mariusmotea/Home-Power-Monitor/Schematic_Power-Meter.png

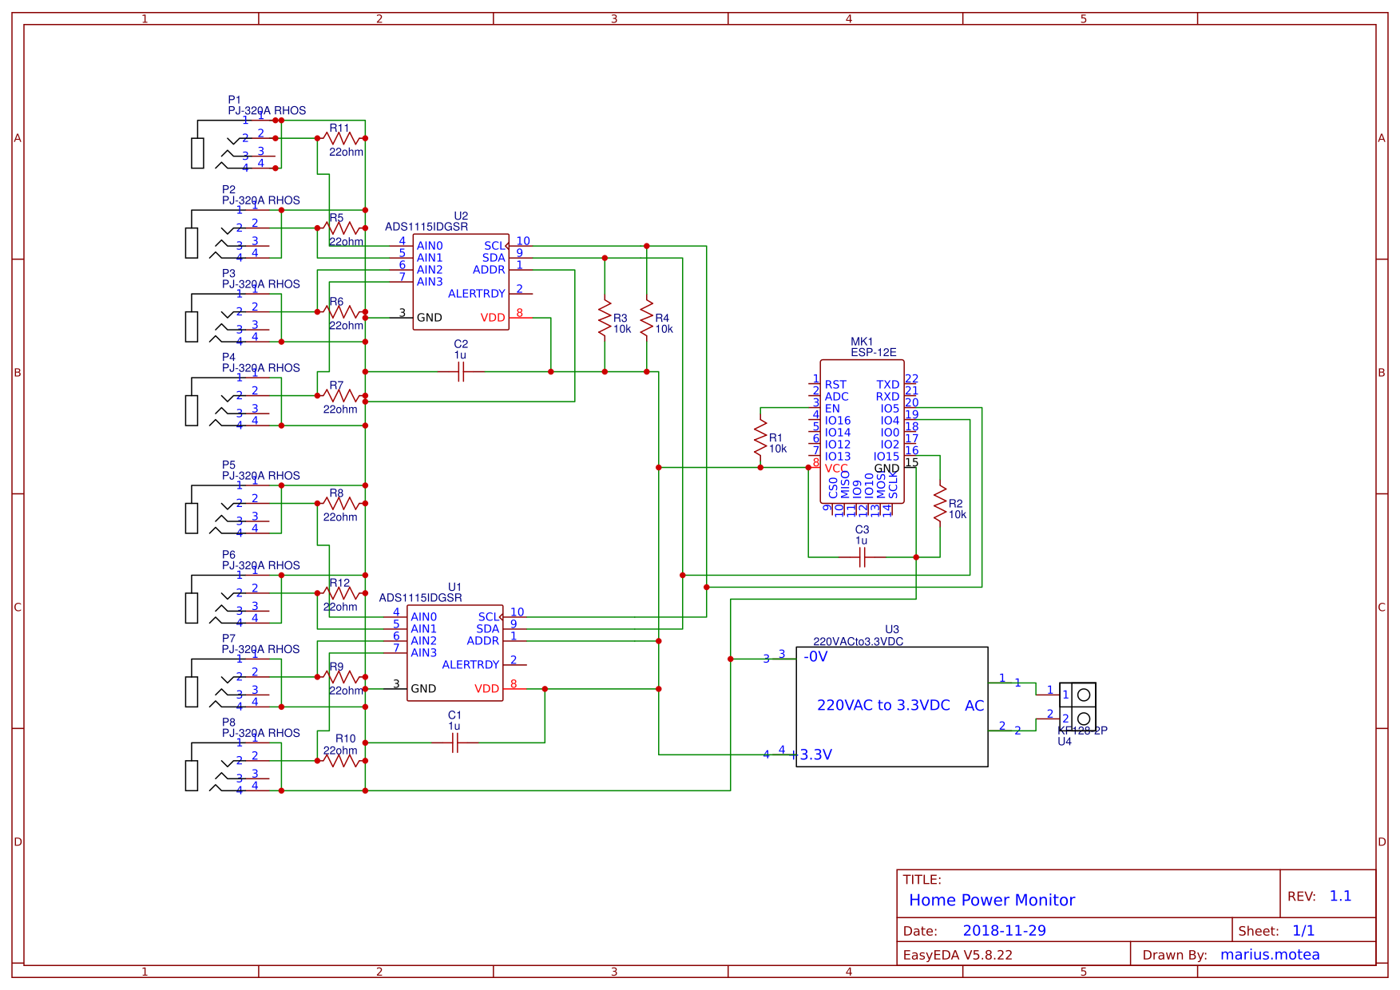
Schematic_Power-Meter.png
