mariusmotea/Home-Power-Monitor/(threads)

Thread 1 (2019-01-30):

EasyEDA link

erazor666, 2019-01-30:
The EasyEDA link seems to link to wrong board? :)

mariusmotea, 2019-01-31:
True, i fixed this. The PCB was updated and now it look also different.

Closed 2019-09-28.

Thread 2 (2019-09-28):

Demultiplier ?

felangga, 2019-09-28:
Hello, I want to ask what the function of demultiplier variable ?
Thank you

mariusmotea, 2019-09-28:
This convert raw data from ADC to Watts. I tune this manually because i have a commercial 220v power measurement tool and with the value present now in the code both devices show same power consumption nomatter the consumption was 1 watt or 500 watts
