mariusmotea/Home-Power-Monitor/(commit log)

2019-01-19 Reset in case wifi connection timeout
    [HomePowerMeter.ino]
2022-01-05 update PCB
2022-12-13 rename power supply to HLK-PM03
